car-lam/boya_SEI/regla/regla_44cm_A4.pdf

10

20

Esta barra debe medir 10,0 cm. Si no, imprime al 100 % / tamaño real.

Regla SEI · tramo 1 de 2 · 0–25 cm
Cortar por las marcas. El 0 cm (abajo) es el extremo que va al fondo.

Esta barra debe medir 10,0 cm. Si no, imprime al 100 % / tamaño real.

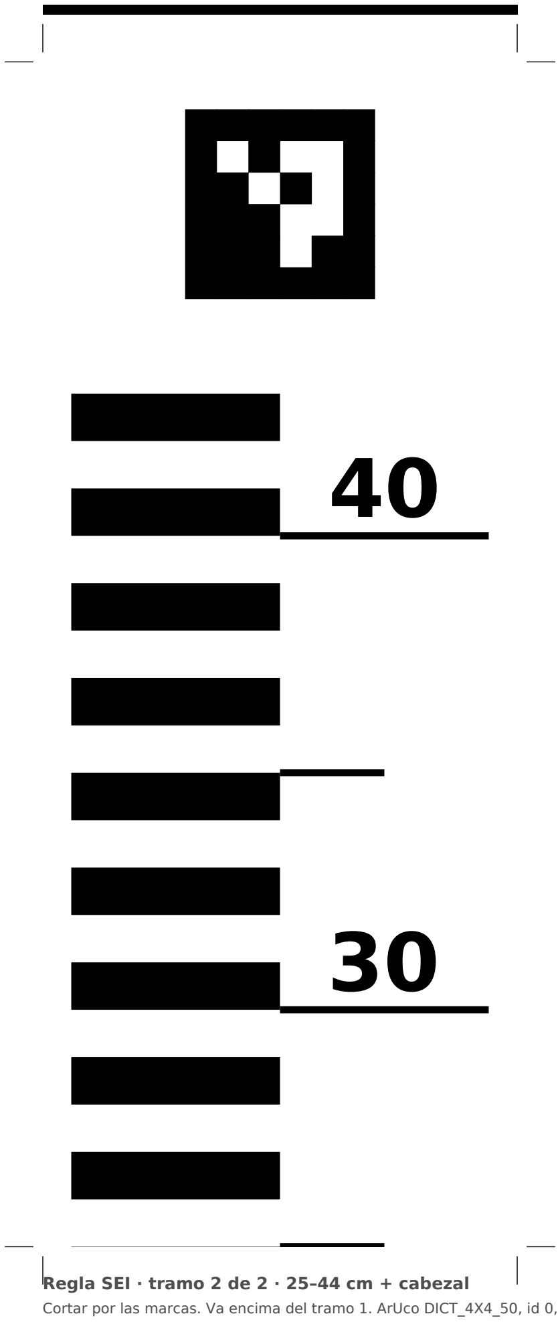
[picture p4: figure]

Regla SEI · tramo 2 de 2 · 25–44 cm + cabezal
Cortar por las marcas. Va encima del tramo 1. ArUco DICT_4X4_50, id 0, lado 40 mm.
