car-lam/boya_SEI/presentacion/avance_2026-11-09.pptx

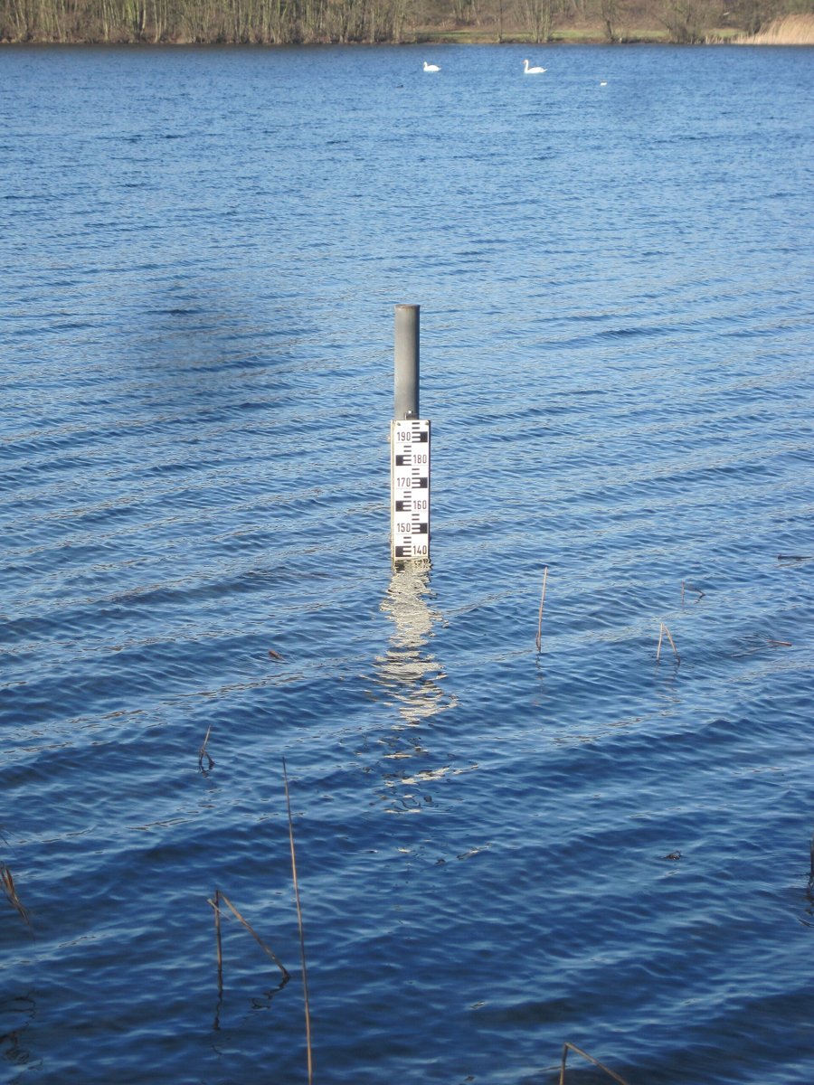
[picture p5: figure]
Regla limnimétrica en el lago Blankensee

Foto: Kresspahl, CC BY-SA 3.0, Wikimedia Commons

SISTEMAS EMBEBIDOS · UTEC 2026-2

Boya de monitoreo ambiental

Red LoRa de alerta de crecidas · Avance del proyecto

Equipo
Carlos Lam · [Integrante 2] · [Integrante 3]
9 de noviembre de 2026

Notes: Presentar al equipo. Idea en una frase: una boya que mide el aire sobre el río y el nivel del agua con una cámara, y manda todo por LoRa a una web que da alertas de crecida.

## Qué medimos y con qué

Dos nodos miden el aire; el tercero mide el nivel del agua con una cámara.

N1 · BME680

PSoC #1

- Temperatura
- Humedad relativa
- Presión
- Gas → calidad del aire

N2 · SCD41

PSoC #2

- CO₂ (ppm)
- Temperatura
- Humedad relativa

N3 · Cámara

PYNQ

- Altura del agua (cm)
- Confianza de la visión
- Vigilancia ≥ 50 cm
- Alerta ≥ 100 cm o +10 cm en 10 min


Notes: N1 y N2 son PSoC con sensores de aire. N3 es la cámara, va en la misma PYNQ que el gateway. Los umbrales de alerta están en internet/config.py y se recalibran en sitio.

## Arquitectura del sistema

PYNQ · gateway

sei.silosense.dev
web (túnel Cloudflare)

N1 · PSoC
BME680 + E220

E220
receptor
LoRa

N3 · Cámara
visión → nivel (cm)

LoRa

N2 · PSoC
SCD41 + E220

Gateway
búfer en disco;
ALERT al instante

SIM800L 2G
o Ethernet

Central · AWS EC2
Flask + SQLite
Hamming → CRC → descifrar

LoRa

POST

Hoy la central recibe datos de un simulador de los 3 nodos, hasta que llegue la radio real.

Notes: Recorrer de izquierda a derecha: los PSoC mandan por LoRa (E220) a la PYNQ. En la PYNQ también corre la cámara (N3). El gateway guarda en disco si no hay señal y reintenta; las alertas salen al instante. Sube por SIM800L o Ethernet a la central en AWS, que valida y muestra todo en sei.silosense.dev.

## Nivel del agua con visión

Umbral de blancos R, G y B ≥ 200

ref06 · Kresspahl, CC BY-SA 3.0

1

2

Apertura (disco 10) quita reflejos y olas

3

Cierre (disco 50) une las franjas en un bloque

4

Rectángulo envolvente recorta la zona de la regla

5

Binarización de la regla recortada

6

Período de franjas mediana por columna, en píxeles

7

Altura 200 cm − regla visible

Funciona en MATLAB con la imagen de prueba. Falta: calibrar con nuestra regla, luz variable, perspectiva y movimiento de la boya.

Notes: Prototipo en camara/main_1.mlx. Entra una foto, sale el nivel. La regla tiene franjas blancas y negras de período conocido: midiendo el período en píxeles se sabe cuántos cm de regla quedan sobre el agua. Siguiente paso: llevarlo a la PYNQ y que publique n3_nivel.json.

## Trama y confiabilidad del enlace

Trama de aplicación (big-endian)

ver

1 B

tipo

1 B

nodo

1 B

seq

2 B

timestamp

4 B

largo

1 B

payload (cifrado)

n B

CRC-16

2 B

En el nodo

Payload
(sensores)

Cifrar
Vigenère / AES-CTR

CRC-CCITT

Hamming (7,4)

LoRa (E220)

En la central

Hamming corrige
1 bit

CRC comprueba

Quita
duplicados

Descifra

Guarda en
SQLite

Tipos: DATA · REQ · ACK · ALERT · HEARTBEAT · TIME_SYNC

Notes: El CRC se calcula antes de Hamming para que la central primero corrija y después compruebe. El número de secuencia sirve para medir pérdidas (PER) y detectar duplicados. Métodos de las ppts: Detección y corrección de errores, Criptografía.

## Central de monitoreo

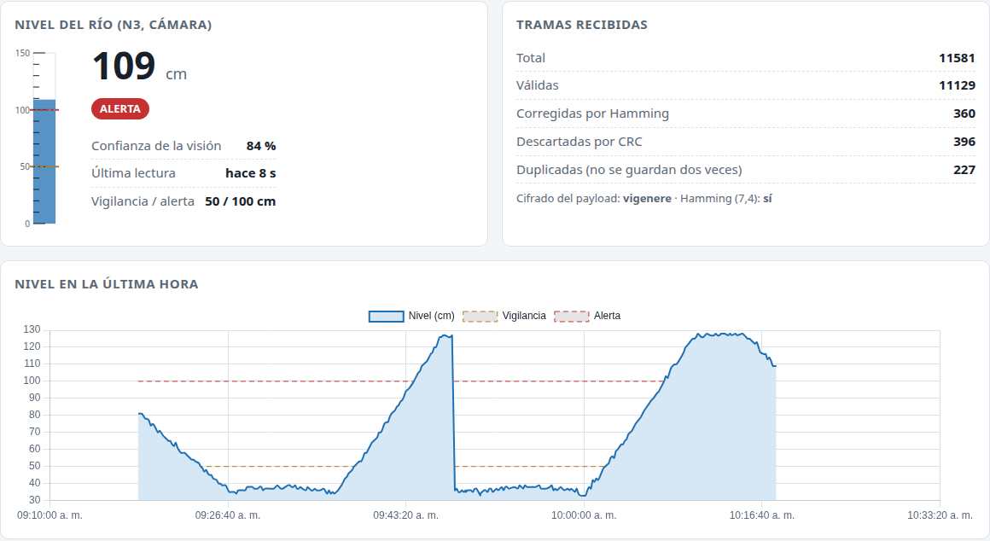
[picture p9: figure]
Captura de la página Resumen de sei.silosense.dev

sei.silosense.dev · datos de demostración del simulador

Resumen
nivel y estado normal / vigilancia / alerta
Calidad de enlace
PER, RSSI, SNR, WMEWMA, Kalman
Capacidad
tiempo en el aire, choques ALOHA, Monte Carlo
Alertas
solo cambios de estado (TEEN)
Tramas
Hamming, CRC y cifrado de cada trama

Notes: Corre en AWS (Flask + SQLite) detrás de un túnel de Cloudflare. Cada página aplica métodos del curso. Ahora los datos vienen del simulador; cuando llegue la radio se apaga sei-simulador.

## Estado del avance

Hecho

- Algoritmo de la regla en MATLAB
- Central web en AWS con simulador
- Trama, CRC, Hamming y cifrado, con pruebas
- Gateway probado sin hardware

En curso

- Configurar los E220 (RSSI y ruido)
- Pasar la visión a la PYNQ
- Probar el SIM800L con un chip en Lima

Pendiente

- Firmware de los nodos PSoC
- Calibrar con la regla real
- Alimentación y carcasa flotante

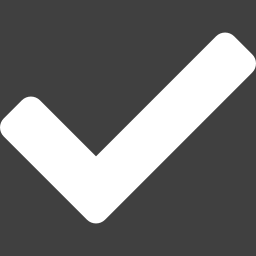
[picture p10: figure]
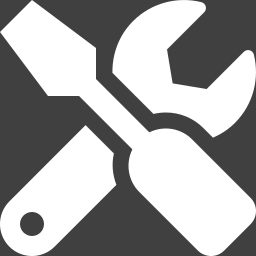
[picture p11: figure]
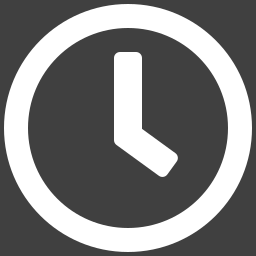
[picture p12: figure]

Notes: Ajustar las columnas con lo que cada uno tenga al día de la presentación.

## Próximos pasos y riesgos

Próximos pasos

Riesgos

El SIM800L es 2G
Probar registro con AT+CREG?; plan B: Ethernet

1

Enlace E220 real entre PSoC y PYNQ


2

Visión en la PYNQ publicando el nivel

La visión depende de la luz
Umbral adaptativo y mediana de varias fotos

3

Apagar el simulador y recibir datos reales

4

Prueba en agua con la boya

La boya se mueve con las olas
Corregir inclinación y perspectiva

Notes: Riesgo principal: la red 2G en Lima. Si el SIM800L no registra, la PYNQ sube por Ethernet/WiFi.

## Slide 9

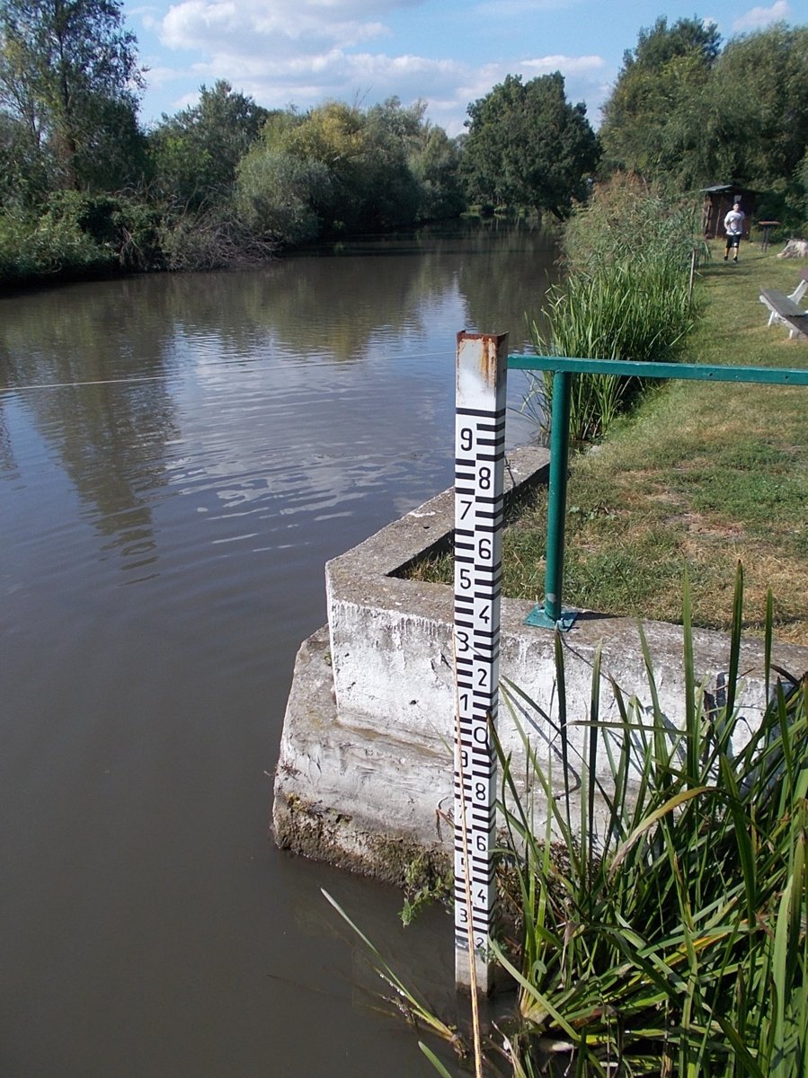
[picture p14: figure]
Regla limnimétrica en un lago de Albertirsa

Foto: Globetrotter19, CC BY-SA 3.0, Wikimedia Commons

Gracias

¿Preguntas?

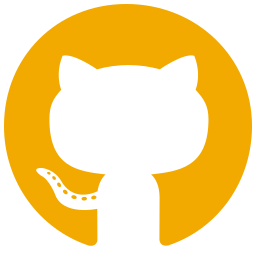
[picture p15: figure]

github.com/car-lam/boya_SEI

sei.silosense.dev

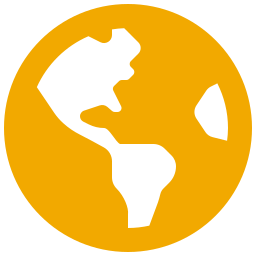
[picture p16: figure]
