car-lam/boya_SEI/mecanica/boya/renders/boya_exterior.png

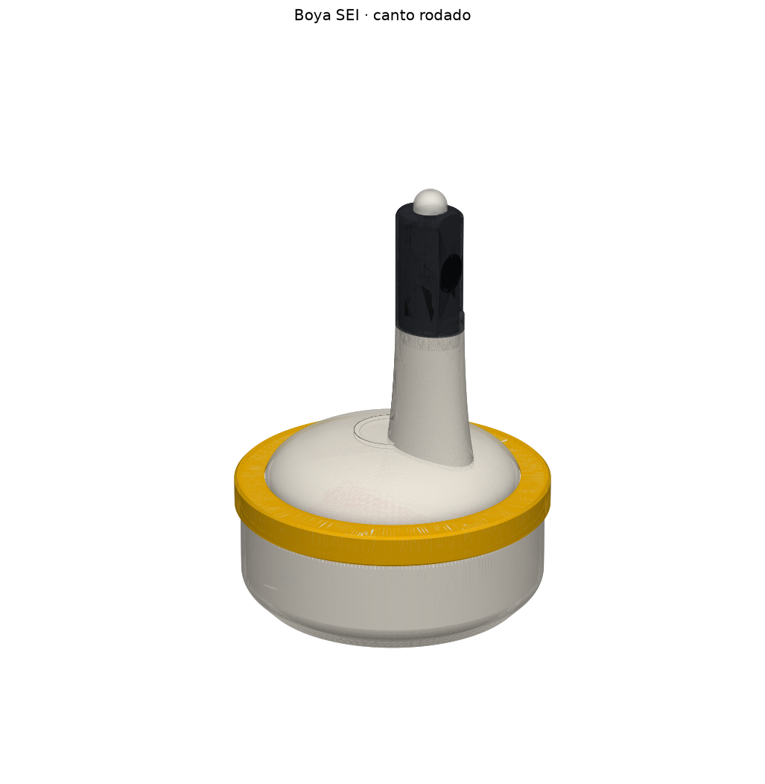
mecanica/boya/renders/boya_exterior.png
