car-lam/boya_SEI/mecanica/boya/renders/boya_interior.png

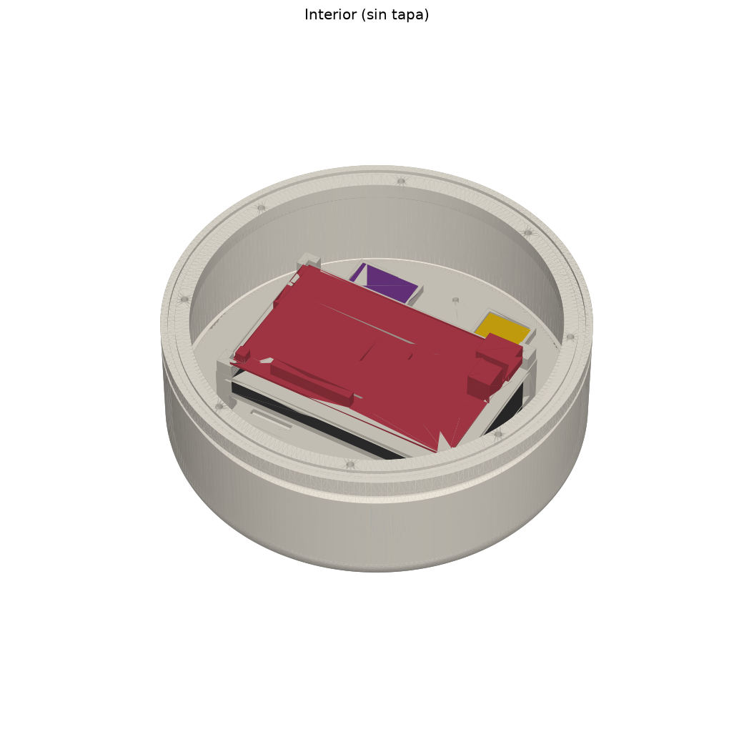
mecanica/boya/renders/boya_interior.png
