car-lam/boya_SEI/regla/vista_regla.png

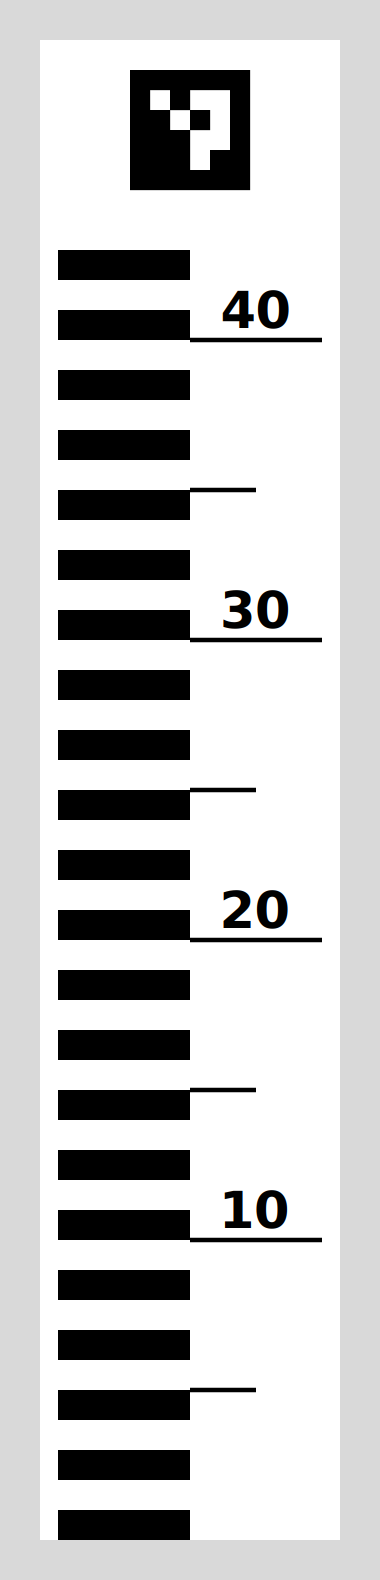
regla/vista_regla.png
