car-lam/boya_SEI/mecanica/boya/step/boya_ensamble.step

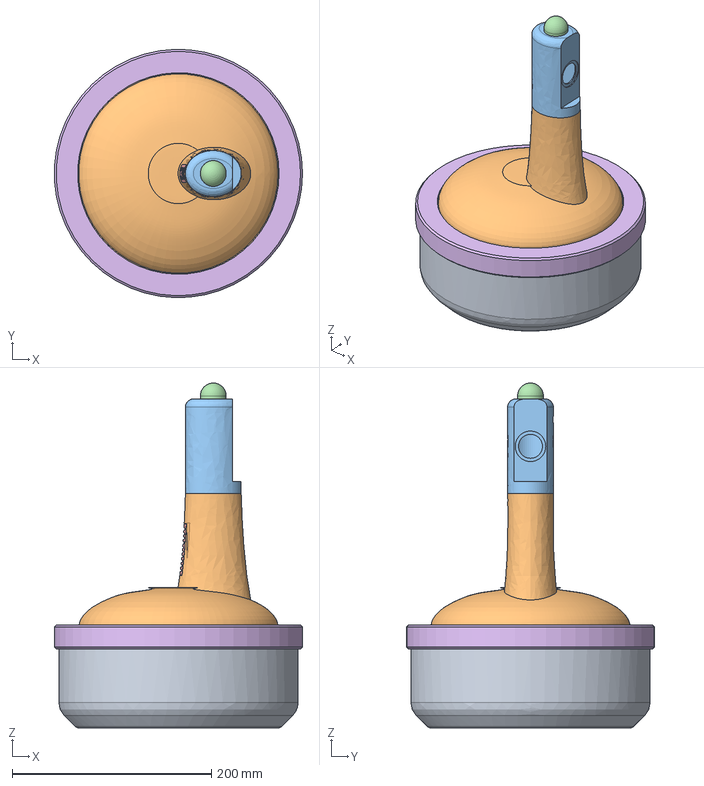
[picture p20: CAD file, 2026-11-09]
mecanica/boya/step/boya_ensamble.step
248.8 x 248.9 x 346.0 mm
casco
tapa_torre
cabeza
farol
rejilla
banda
bandeja
estante_pynq
