car-lam/boya_SEI/mecanica/boya/step/bandeja.step

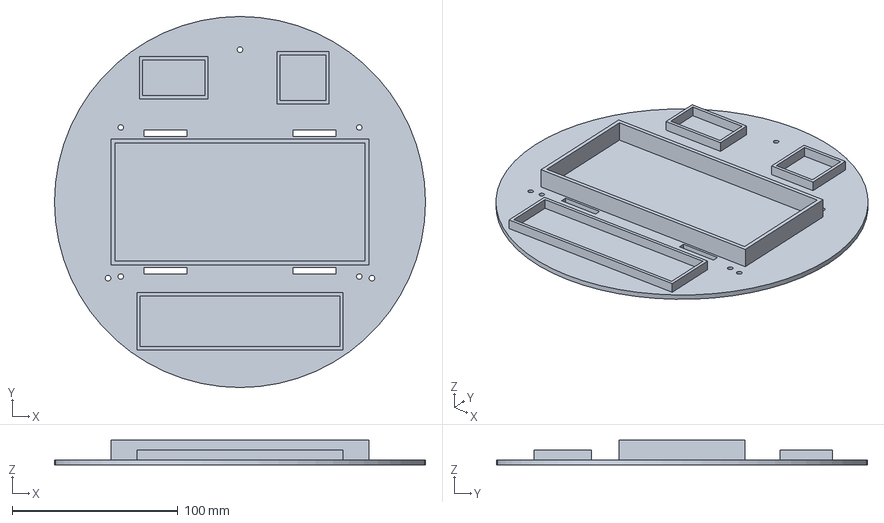
[picture p21: CAD file, 2026-11-09]
mecanica/boya/step/bandeja.step
224.0 x 224.0 x 15.0 mm
