car-lam/boya_SEI/mecanica/boya/step/rejilla.step

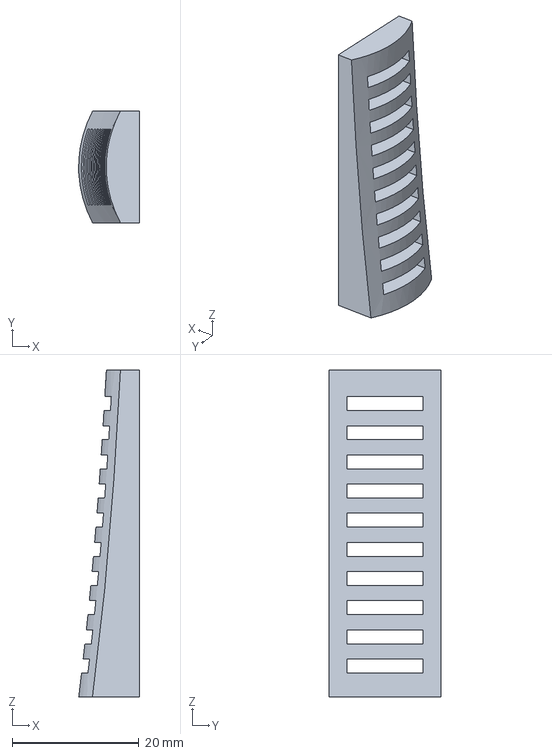
[picture p22: CAD file, 2026-11-09]
mecanica/boya/step/rejilla.step
9.56 x 17.6 x 51.6 mm
