car-lam/boya_SEI/mecanica/boya/step/cabeza.step

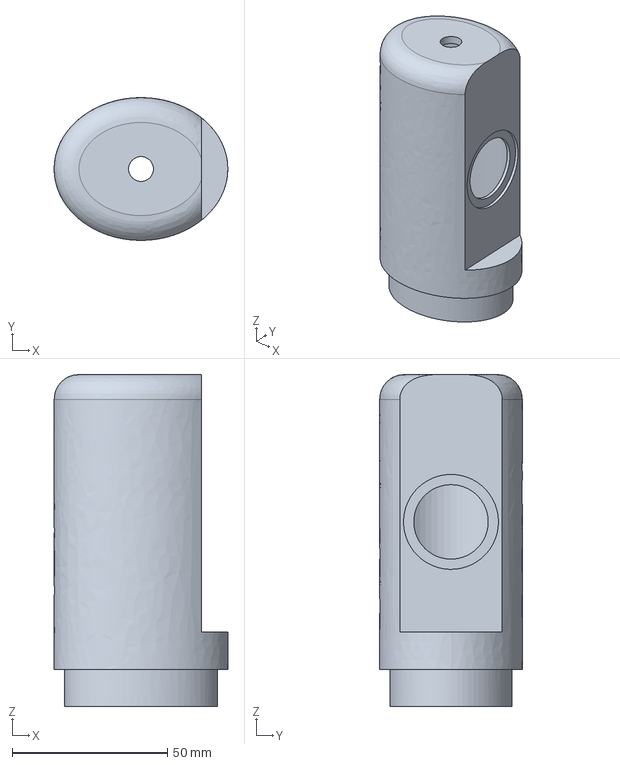
[picture p23: CAD file, 2026-11-09]
mecanica/boya/step/cabeza.step
56.0 x 46.0 x 107.0 mm
