car-lam/boya_SEI/mecanica/boya/step/banda.step

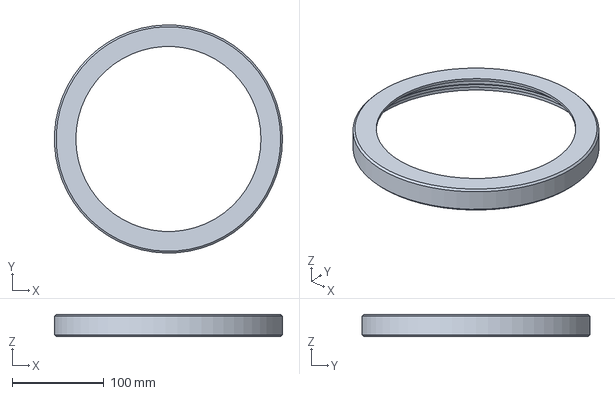
[picture p24: CAD file, 2026-11-09]
mecanica/boya/step/banda.step
248.8 x 248.9 x 24.5 mm
