car-lam/boya_SEI/mecanica/boya/step/casco.step

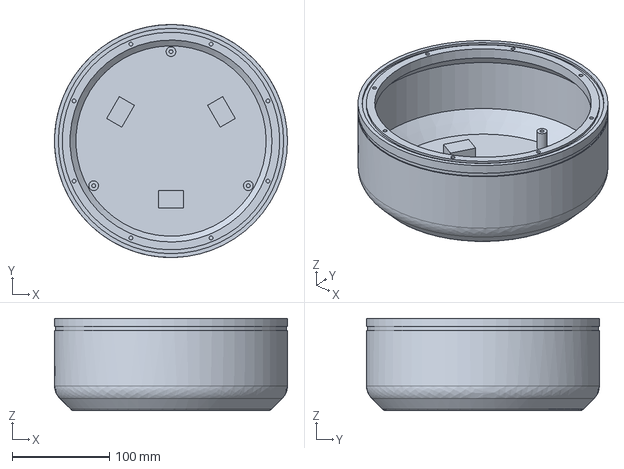
[picture p25: CAD file, 2026-11-09]
mecanica/boya/step/casco.step
240.0 x 240.0 x 95.0 mm
