car-lam/boya_SEI/mecanica/boya/step/estante_pynq.step

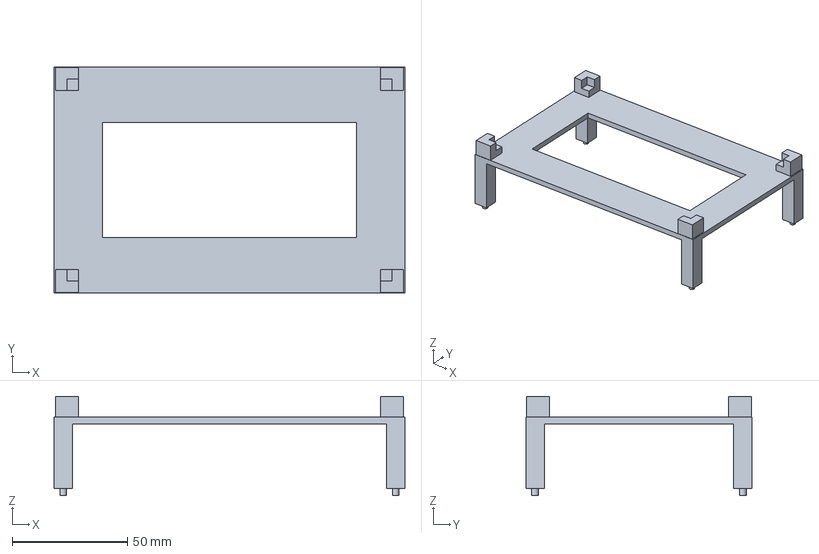
[picture p26: CAD file, 2026-11-09]
mecanica/boya/step/estante_pynq.step
152.0 x 98.0 x 43.0 mm
