car-lam/boya_SEI/mecanica/boya/step/farol.step

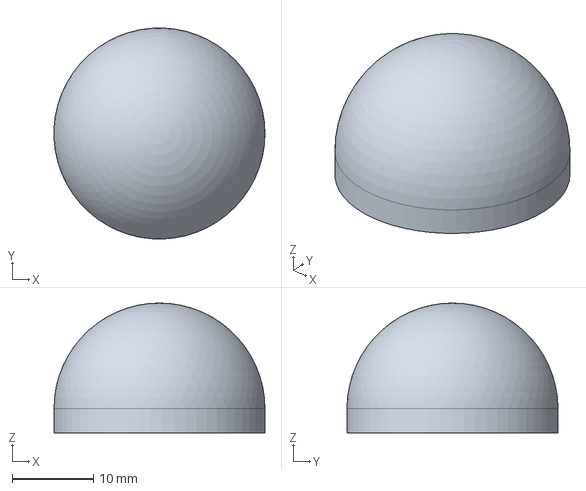
[picture p27: CAD file, 2026-11-09]
mecanica/boya/step/farol.step
26.0 x 26.0 x 16.0 mm
