car-lam/boya_SEI/mecanica/boya/step/tapa_torre.step

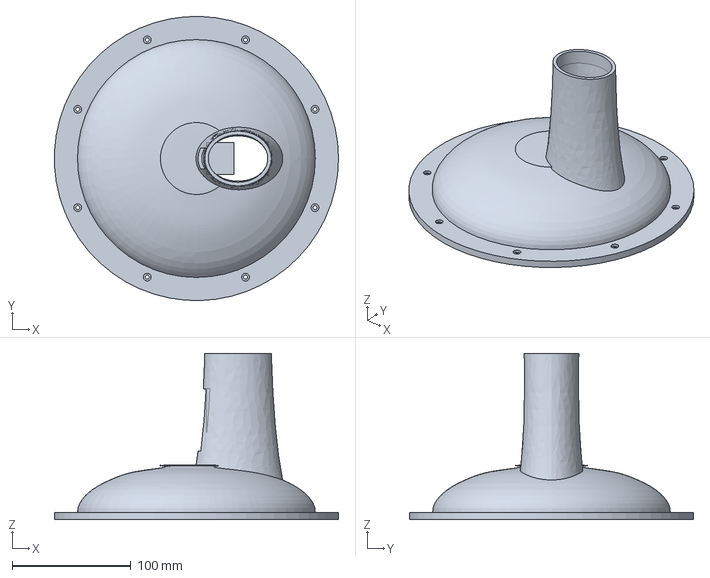
[picture p28: CAD file, 2026-11-09]
mecanica/boya/step/tapa_torre.step
238.8 x 238.9 x 140.0 mm
