car-lam/boya_SEI/(list of files, cad)

Other CAD files:
mecanica/boya/stl/banda.stl
mecanica/boya/stl/bandeja.stl
mecanica/boya/stl/cabeza.stl
mecanica/boya/stl/casco.stl
mecanica/boya/stl/estante_pynq.stl
mecanica/boya/stl/farol.stl
mecanica/boya/stl/rejilla.stl
mecanica/boya/stl/tapa_torre.stl
