car-lam/boya_SEI/(commit log)

2026-11-09 Regla limnimétrica para la feria: 44 cm + ArUco, PDF en 2 hojas A4
    Escalera de franjas de 1 cm (período 2 cm) para la visión, números cada
    10 cm, cabezal con ArUco DICT_4X4_50 id 0 para ubicar la regla y corregir
    perspectiva. Se imprime en blanco y negro; borde rojo opcional (--borde rojo).
2026-11-09 Diseño 3D paramétrico de la boya (CadQuery) y renders en Blender
    Disco Ø240×95 mm en PLA con tapa de o-ring y 8 M3, bandeja con powerbank
    abajo y PYNQ-Z2 en estante, PSoC 5LP, E220 e IMU de la base; mástil de
    cámara con bisagra, palo del viento y caseta de sensores en la tapa.
    boya.py genera STL/STEP y estima flotación (~1,76 kg, calado ~40 mm,
    GM ~34 mm). Medidas de placas aproximadas: medir antes de imprimir.
    [bandeja.step, bandeja.stl, boya_ensamble.step, casco.step, casco.stl, caseta_sensores.step, caseta_sensores.stl, estante_pynq.step]
2026-11-09 Rediseño «canto rodado» de la boya
    Cubierta abombada y torre elíptica hueca (cables y antena por dentro) en
    una sola pieza; cabeza con webcam vertical tras visor plano y ventana de
    acrílico, farol LED de estado, rejilla de sensores al ras, banda de TPU
    amarilla que tapa los tornillos y ojales de amarre bajo el casco. Sin el
    palo del viento por ahora. ~2,2 kg, calado ~51 mm, GM ~26 mm.
    Renders de Blender actualizados (escena con regla, frente e interior).
    [banda.step, banda.stl, bandeja.step, bandeja.stl, boya_ensamble.step, cabeza.step, cabeza.stl, casco.step]
